standbych/ZigerSimonSays/README.md

# ZigerSimonSays
Simon Says Clone

Requirements
- https://github.com/adafruit/Adafruit-GFX-Library
- https://github.com/adafruit/Adafruit_SSD1306
