standbych/ZigerSimonSays/hardware/outline.dxf

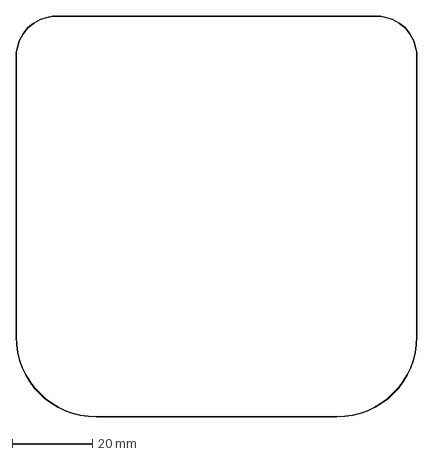
[picture p1: CAD file, 2022-02-08]
hardware/outline.dxf
100.0 x 100.0 mm
