standbych/ZigerSimonSays/hardware/SimonSays.kicad_pcb

## KiCad design hardware/SimonSays.kicad_pcb (2022-02-08)

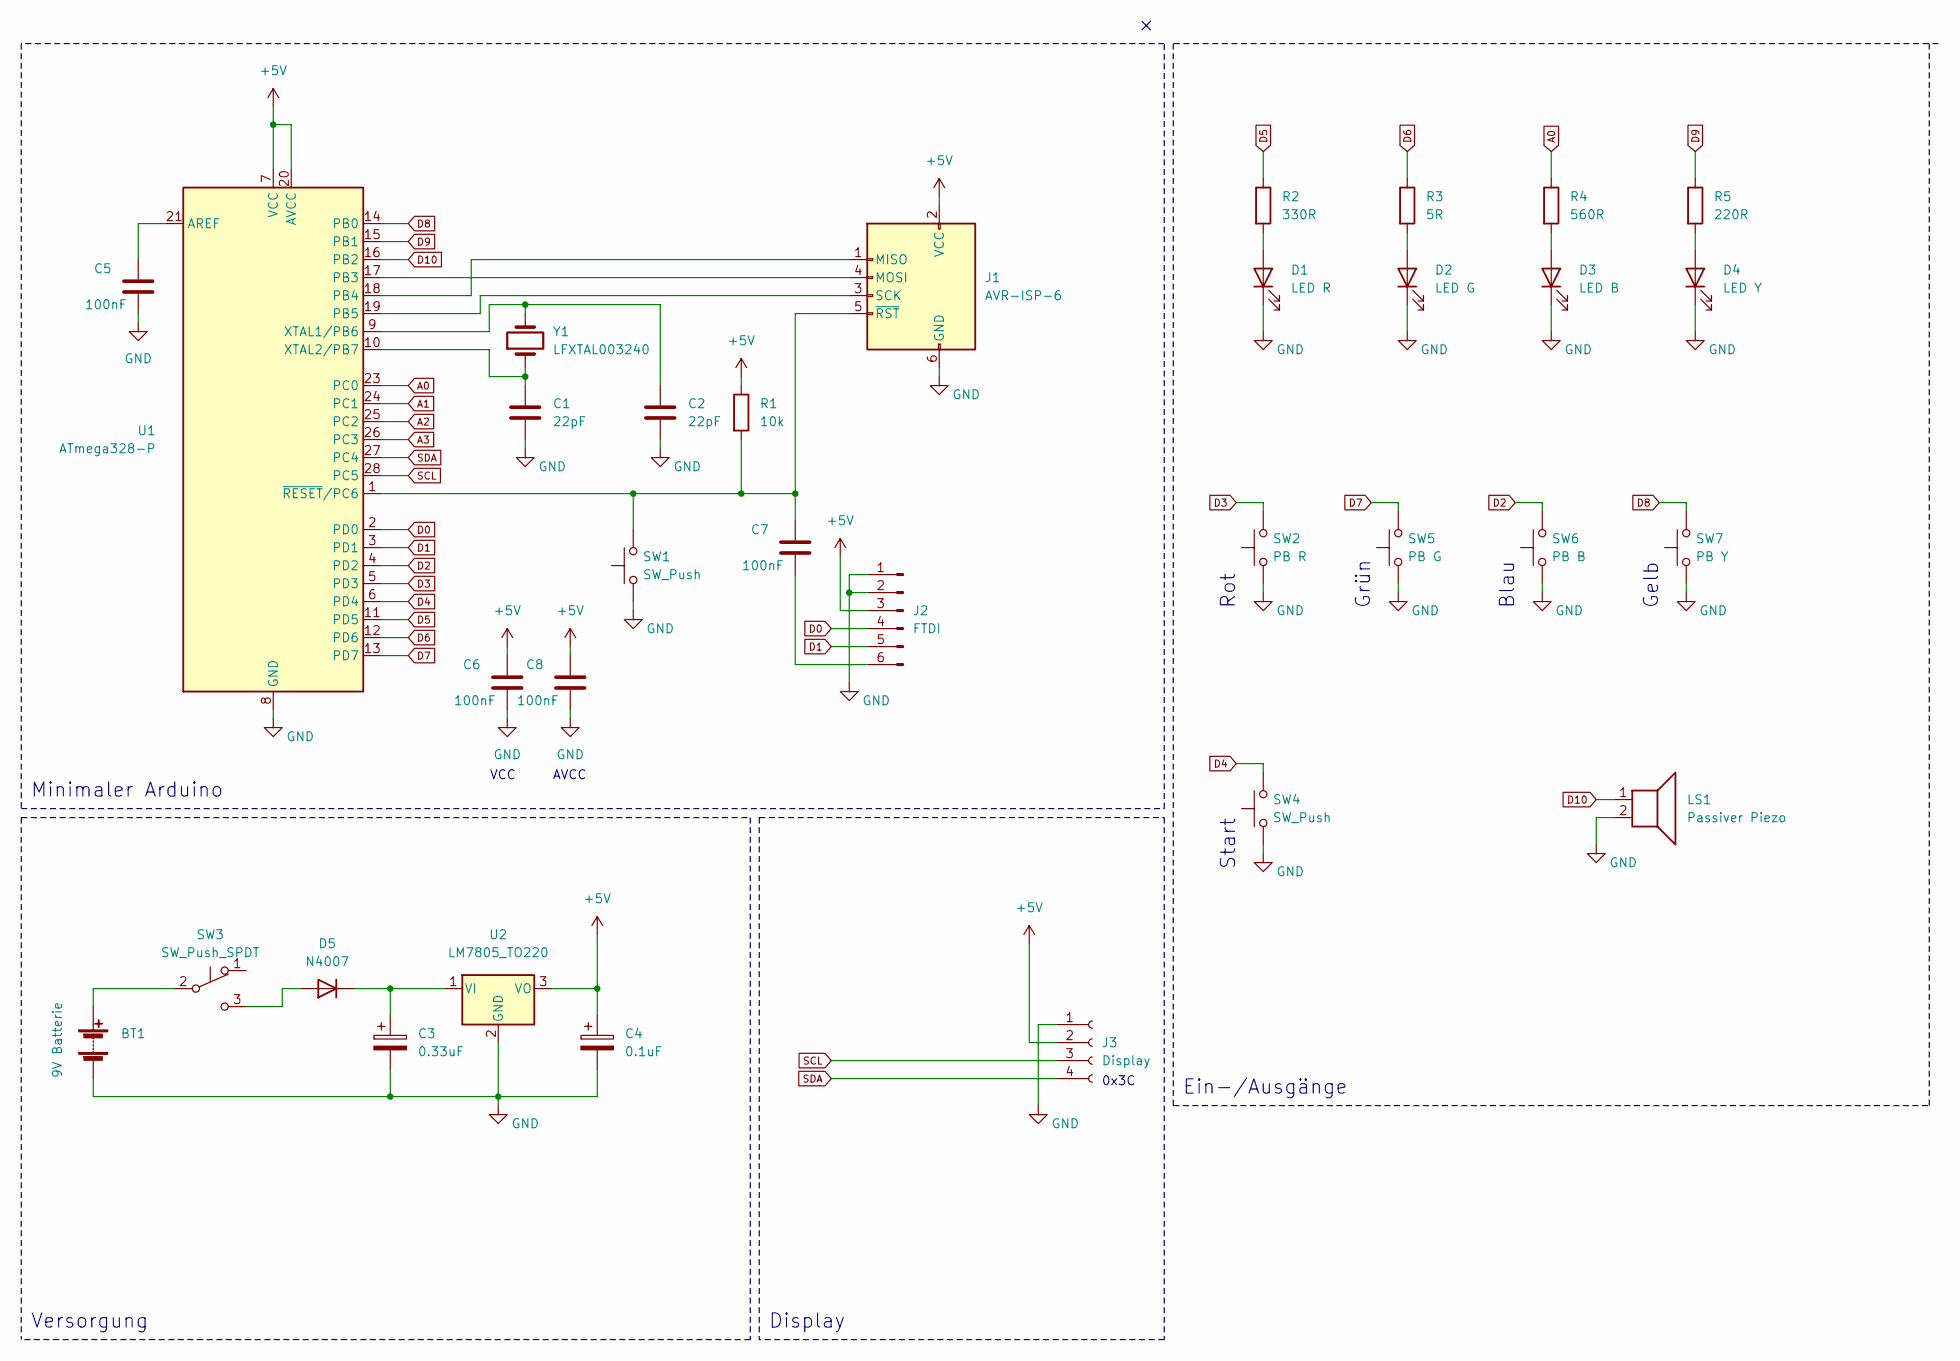
[picture p2: schematic SimonSays.kicad_sch, Simonsaysduino]

Parts:
BT1: 9V Batterie; BatteryHolder_Eagle_12BH611-GR; Manufacturer Part Number MP000351
C1, C2: 22pF; C_Disc_D5.0mm_W2.5mm_P2.50mm
C3: 0.33uF; CP_Radial_D5.0mm_P2.50mm
C4: 0.1uF; CP_Radial_D5.0mm_P2.50mm
C5, C6, C7, C8: 100nF; C_Disc_D5.0mm_W2.5mm_P2.50mm
D1: LED R; LED_D10.0mm
D2: LED G; LED_D10.0mm
D3: LED B; LED_D10.0mm
D4: LED Y; LED_D10.0mm
D5: N4007; D_5W_P10.16mm_Horizontal
J1: AVR-ISP-6; PinHeader_2x03_P2.54mm_Vertical
J2: FTDI; PinHeader_1x06_P2.54mm_Vertical
J3: Display; Display_128x64_096_I2C_no_holes
LS1: Passiver Piezo; Buzzer_12x9.5RM7.6
R1: 10k; R_Axial_DIN0207_L6.3mm_D2.5mm_P10.16mm_Horizontal
R2: 330R; R_Axial_DIN0207_L6.3mm_D2.5mm_P10.16mm_Horizontal
R3: 5R; R_Axial_DIN0207_L6.3mm_D2.5mm_P10.16mm_Horizontal
R4: 560R; R_Axial_DIN0207_L6.3mm_D2.5mm_P10.16mm_Horizontal
R5: 220R; R_Axial_DIN0207_L6.3mm_D2.5mm_P10.16mm_Horizontal
SW1: SW_Push; SW_PUSH_6mm
SW2: PB R; Button_12*12*7.3_red_round
SW3: SW_Push_SPDT; cheap_china_slide_switch
SW4: SW_Push; Button_12*12*7.3_white_round
SW5: PB G; Button_12*12*7.3_green_round
SW6: PB B; Button_12*12*7.3_blue_round
SW7: PB Y; Button_12*12*7.3_yellow_round
U1: ATmega328-P; DIP-28_W7.62mm
U2: LM7805_TO220; TO-220-3_Horizontal_TabDown
Y1: LFXTAL003240; Crystal_HC50_Vertical

Connections:
+5V: C4.1, C6.1, C8.1, J1.2 (VCC), J2.3, J3.2, R1.1, U1.7 (VCC), U1.20 (AVCC), U2.3 (VO)
A0: R4.1, U1.23 (PC0)
A1: U1.24 (PC1)
A2: U1.25 (PC2)
A3: U1.26 (PC3)
D0: J2.4, U1.2 (PD0)
D1: J2.5, U1.3 (PD1)
D2: SW6.2, U1.4 (PD2)
D3: SW2.2, U1.5 (PD3)
D4: SW4.2, U1.6 (PD4)
D5: R2.1, U1.11 (PD5)
D6: R3.1, U1.12 (PD6)
D7: SW5.2, U1.13 (PD7)
D8: SW7.2, U1.14 (PB0)
D9: R5.1, U1.15 (PB1)
D10: LS1.1, U1.16 (PB2)
GND: BT1.2 (-), C1.2, C2.2, C3.2, C4.2, C5.2, C6.2, C8.2, D1.1 (K), D2.1 (K), D3.1 (K), D4.1 (K), J1.6 (GND), J2.1, J2.2, J3.1, LS1.2, SW1.1, SW2.1, SW4.1, SW5.1, SW6.1, SW7.1, U1.8 (GND), U1.22 (GND), U2.2 (GND)
unnamed: BT1.1 (+), SW3.2 (B)
unnamed: C1.1, U1.10 (XTAL2/PB7), Y1.1
unnamed: C2.1, U1.9 (XTAL1/PB6), Y1.2
unnamed: C3.1, D5.1 (K), U2.1 (VI)
unnamed: C5.1, U1.21 (AREF)
unnamed: C7.1, J1.5 (~RST), R1.2, SW1.2, U1.1 (~RESET/PC6)
unnamed: C7.2, J2.6
unnamed: D1.2 (A), R2.2
unnamed: D2.2 (A), R3.2
unnamed: D3.2 (A), R4.2
unnamed: D4.2 (A), R5.2
unnamed: D5.2 (A), SW3.3 (C)
unnamed: J1.1 (MISO), U1.18 (PB4)
unnamed: J1.3 (SCK), U1.19 (PB5)
unnamed: J1.4 (MOSI), U1.17 (PB3)
SCL: J3.3, U1.28 (PC5)
SDA: J3.4, U1.27 (PC4)

Notes on the sheet:
Minimaler Arduino
Versorgung
VCC
AVCC
Display
0x3C
Ein-/Ausgänge
Rot
Start
Grün
Blau
Gelb

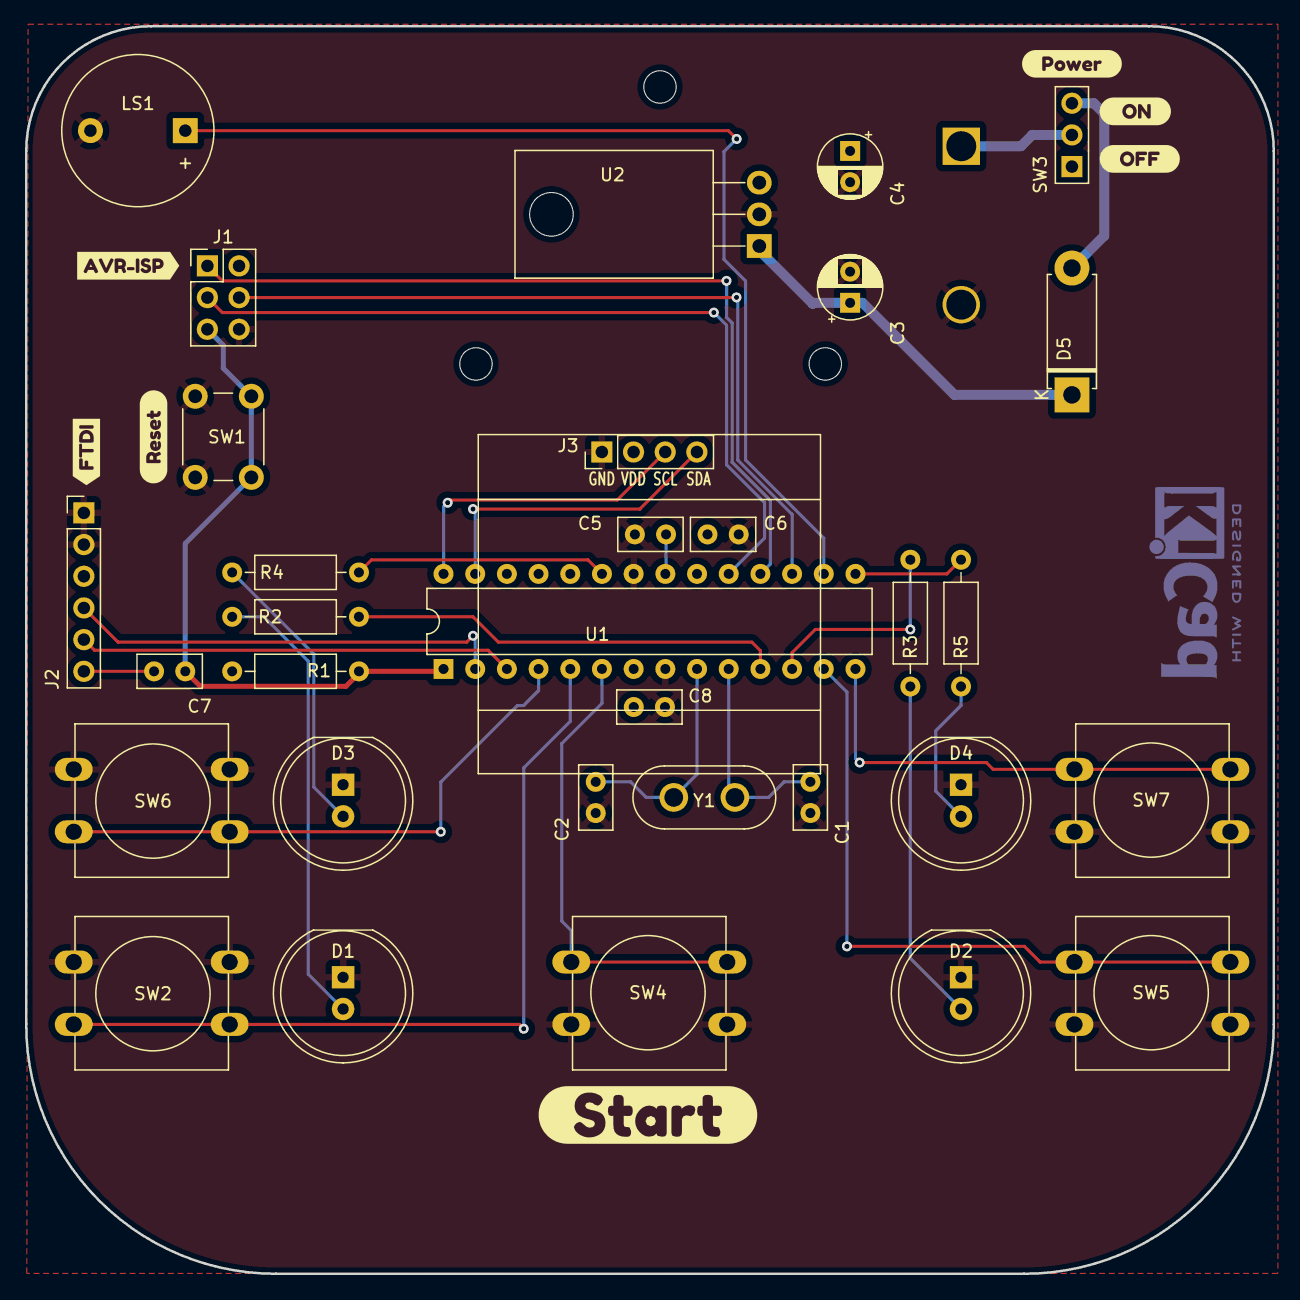
[picture p3: board SimonSays.kicad_pcb from above]

Board: 2 copper layers, 100.0 x 100.0 mm, 40 parts (1 on the bottom side), 31 nets.

Other parts of the board:
kibuzzard-6160B6E4: G***; kibuzzard-6160B6E4
kibuzzard-6160B38A: G***; kibuzzard-6160B38A
kibuzzard-6160B392: G***; kibuzzard-6160B392
kibuzzard-61609DB8: G***; kibuzzard-61609DB8
kibuzzard-61609DF8: G***; kibuzzard-61609DF8
kibuzzard-61609E2B: G***; kibuzzard-61609E2B
kibuzzard-61609E4D: G***; kibuzzard-61609E4D
