standbych/ZigerSimonSays/Code/SimonSays2/Highscore.cpp

#include "Highscore.h"

// Statische Methode zum Abrufen des Highscores
int Highscore::get() {
  int result;
  EEPROM.get(0, result);
  if (result == -1) {
    result = 0;
  }
  return result;
}

// Statische Methode zum Setzen des Highscores
void Highscore::set(int highscore) {
  EEPROM.put(0, highscore);
}
