standbych/ZigerSimonSays/Code/SimonSays/locale.h

//Uncomment preferred language

//ENGLISCH
//const String str_del_highscore =          "  Delete highscore?";
//const String str_conf_del_highscore =     "YES: press green";
//const String str_abort_del_highscore =    "NO:  press red";
//const String str_eeprom_deleted =         "DELETED";
//const String str_eeprom_exit =            "EXIT";
//const String str_col_red =                "red";
//const String str_col_green =              "green";
//const String str_col_blue =               "blue";
//const String str_col_yellow =             "yellow";
//const String str_start_press =            "   Press  ";
//const String str_start =                  "   START  ";
//const String str_simon_simon =            "Simon";
//const String str_simon_says =             "says...";
//const String str_simon_you =              "you";
//const String str_simon_say =              "say...";
//const String str_simon_correct =          "correct!";
//const String str_simon_wrong =            "wrong!";
//const String str_highscore =              "highscore";
//const String str_hs_points =              " points";
//const String str_hs_gameover =            "Game over!";




//DEUTSCH
const String str_del_highscore =          " Highscore loeschen?";
const String str_conf_del_highscore =     "JA:    Gruen druecken";
const String str_abort_del_highscore =    "NEIN:  Rot druecken";
const String str_eeprom_deleted =         "GELOESCHT";
const String str_eeprom_exit =            "ABBRUCH";
const String str_col_red =                "Rot";
const String str_col_green =              "Gruen";
const String str_col_blue =               "Blau";
const String str_col_yellow =             "Gelb";
const String str_start_press =            "  Druecke ";
const String str_start =                  "   START  ";
const String str_simon_simon =            "Simon";
const String str_simon_says =             "sagt...";
const String str_simon_you =              "Du";
const String str_simon_say =              "sagst...";
const String str_simon_correct =          "Richtig!";
const String str_simon_wrong =            "Falsch!";
const String str_highscore =              "Highscore";
const String str_hs_points =              " Punkte";
const String str_hs_gameover =            "Game over!";
